mostlydiyrf/UDVBM-1/README.md

# UDVBM-1
Kicad (ver.6) design files, Arduino sketches, and user documents.
