mostlydiyrf/UDVBM-1/docs/UDVBM-1_schematics.pdf

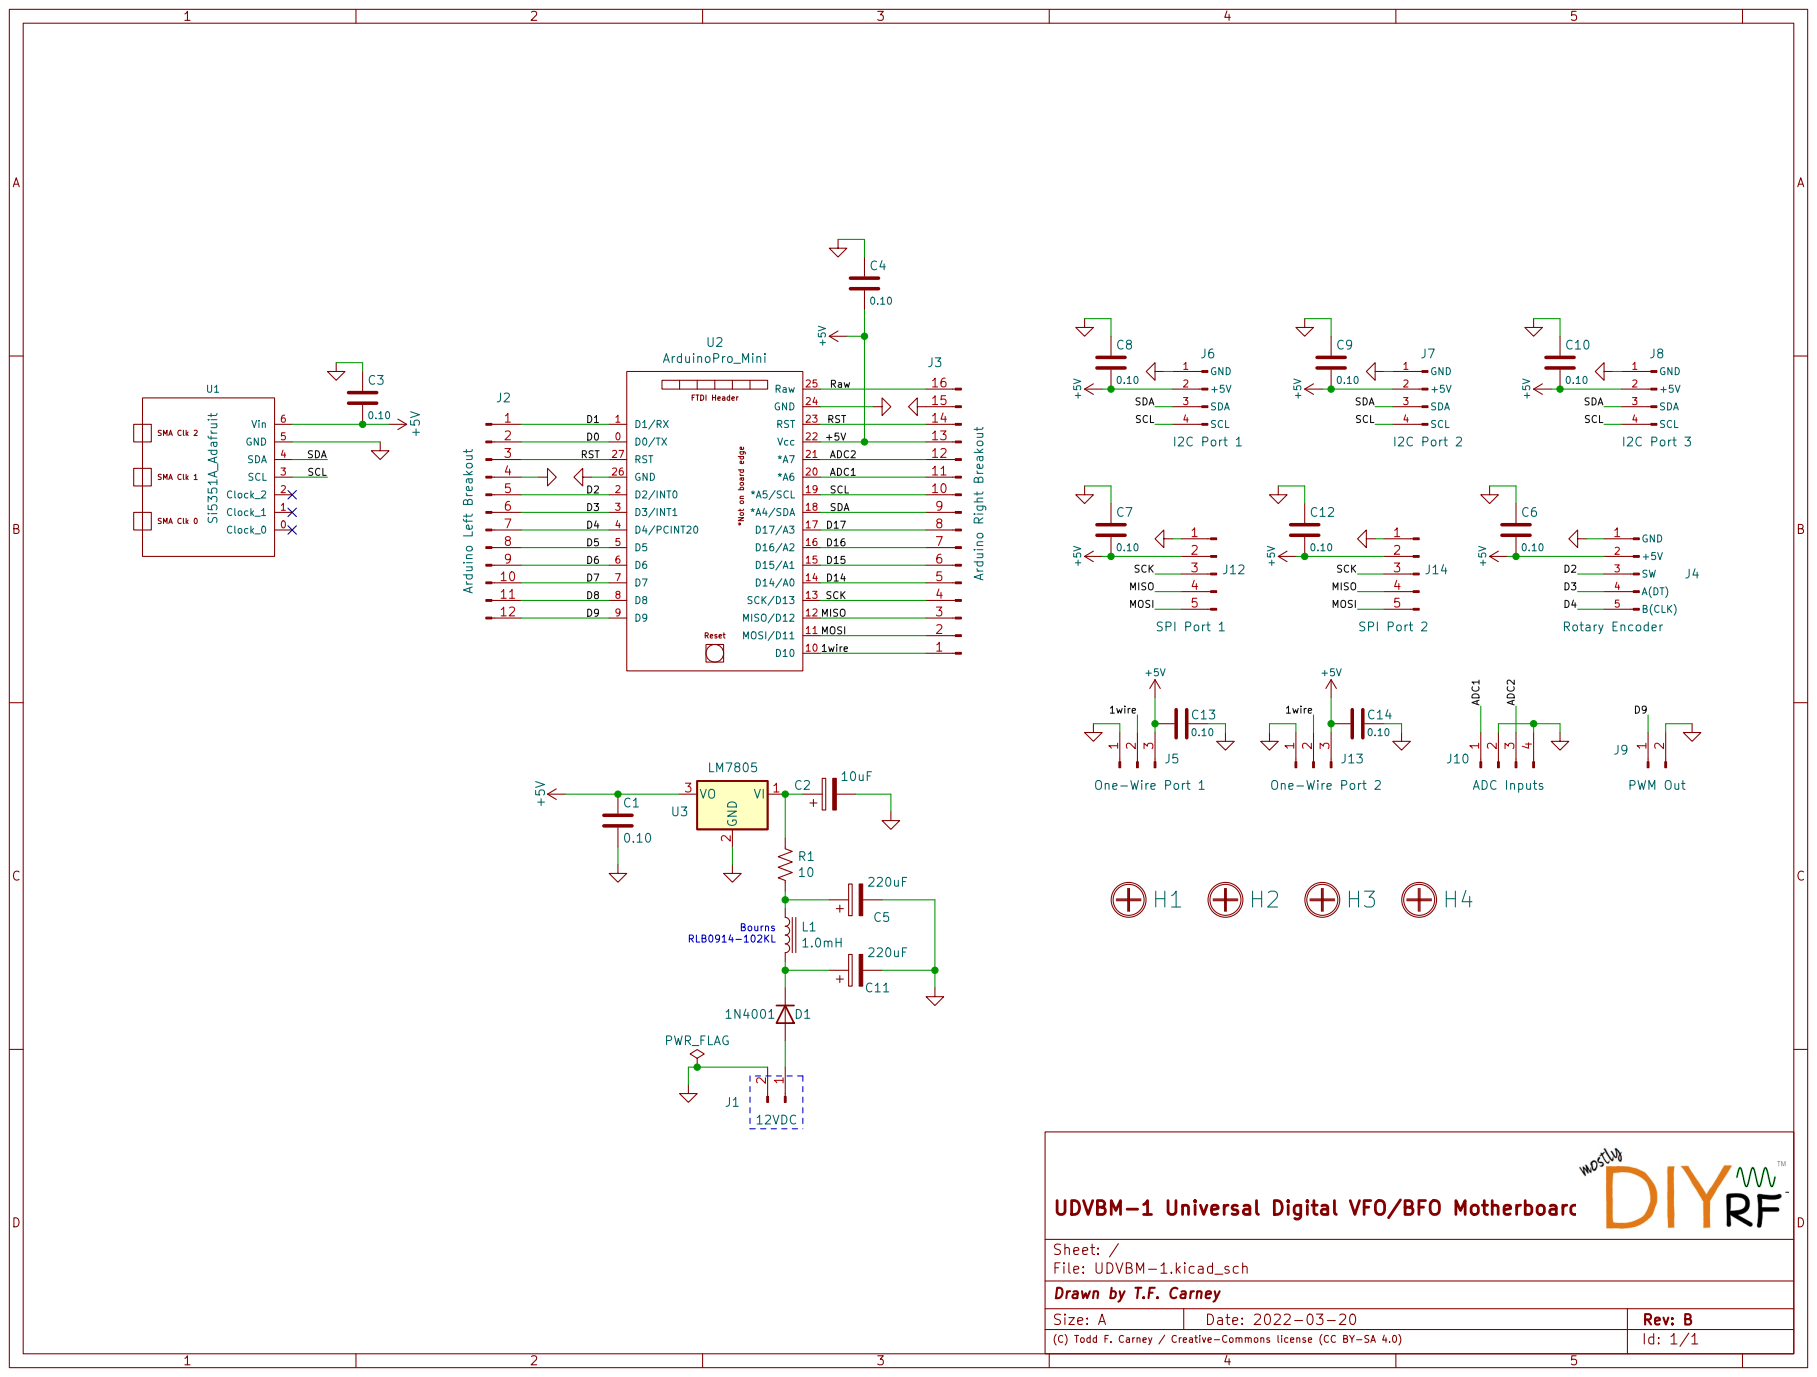
[picture p24: page 1]

File: UDVBM-1.kicad_sch Sheet: / UDVBM-1 Universal Digital VFO/BFO Motherboard

Id: 1/1 Drawn by T.F. Carney

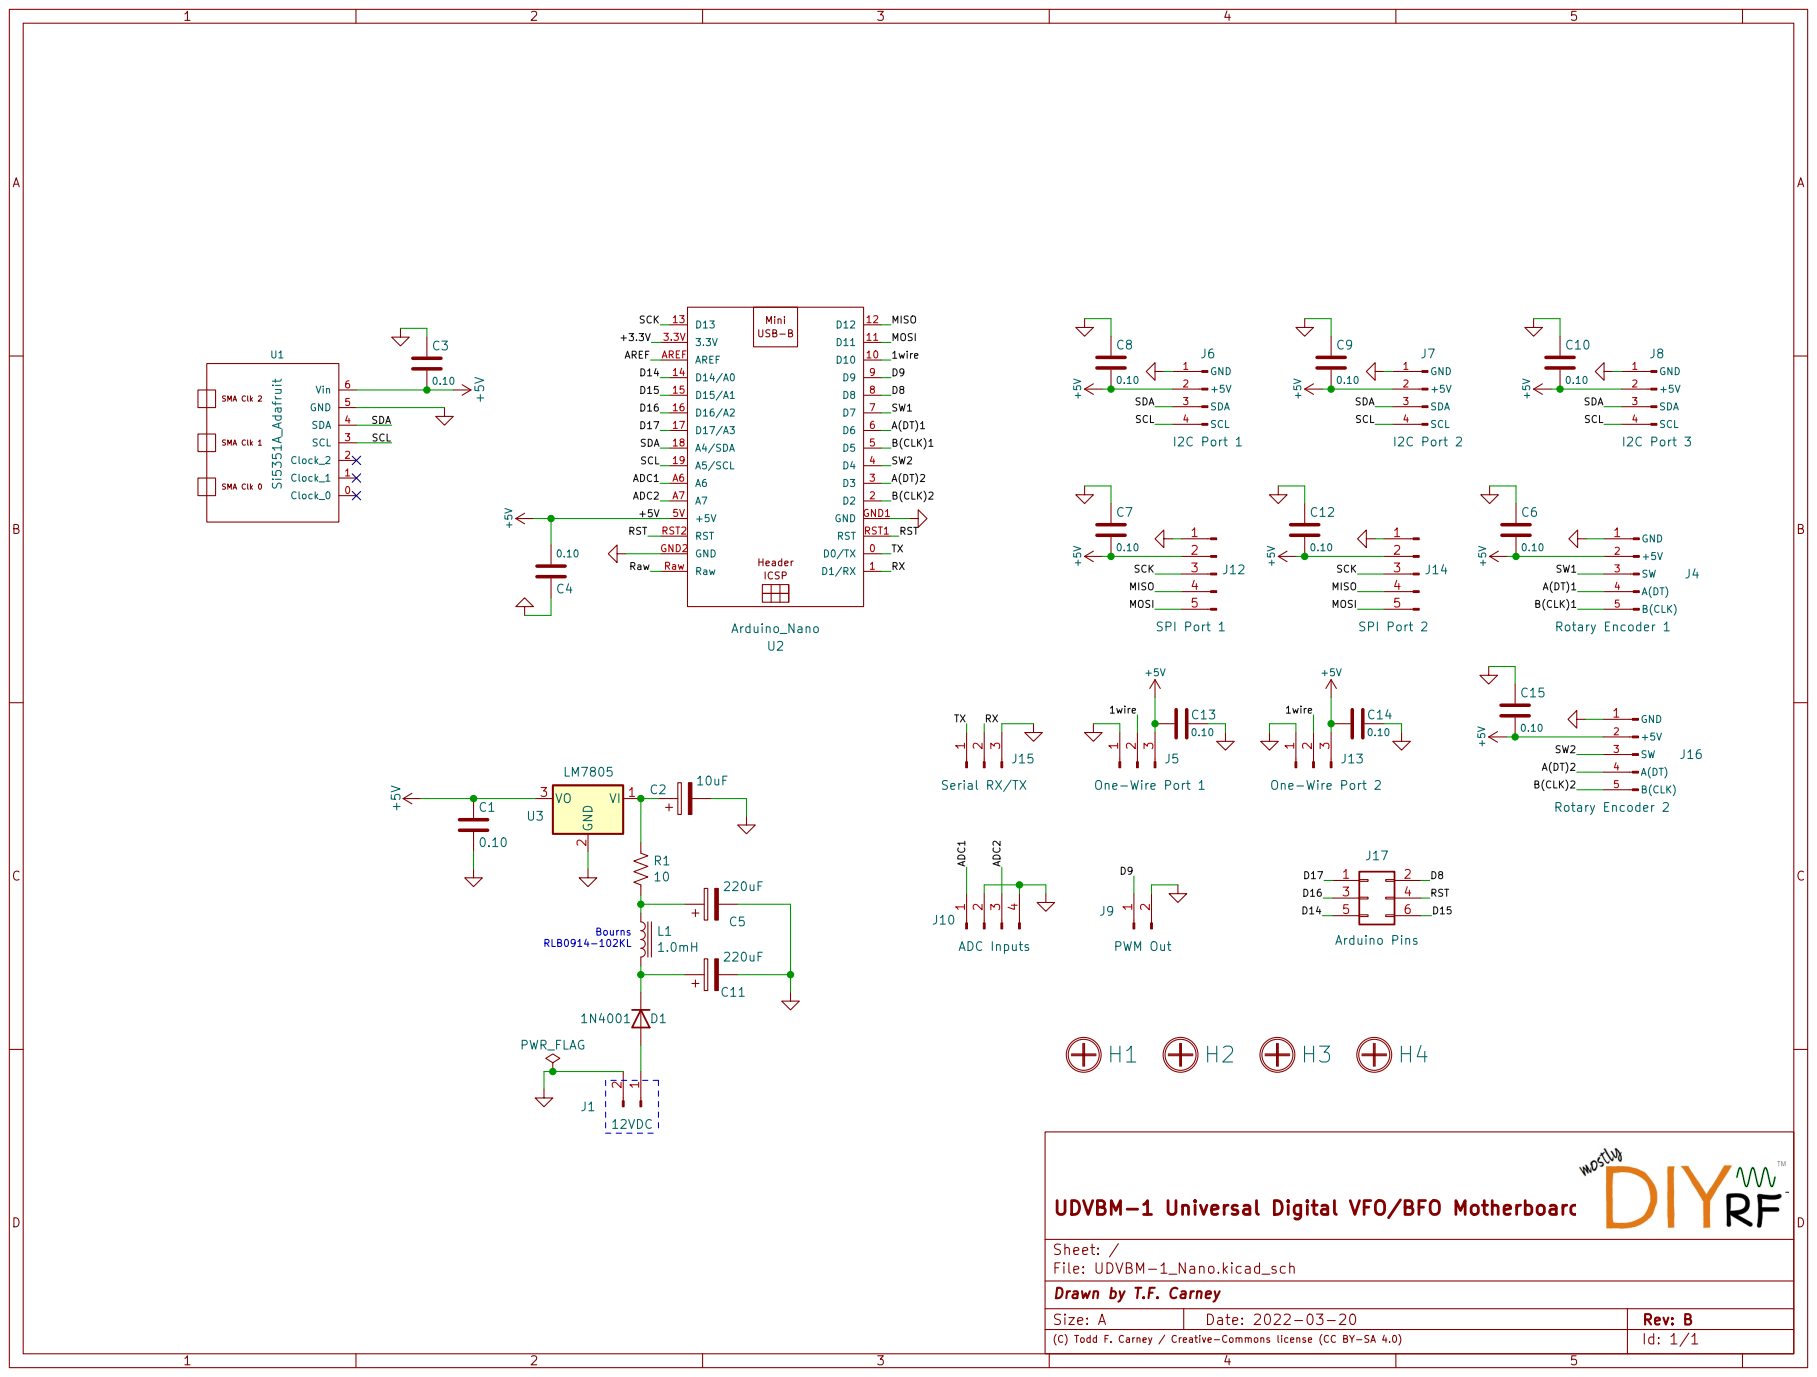
[picture p25: page 2]

File: UDVBM-1_Nano.kicad_sch Sheet: / UDVBM-1 Universal Digital VFO/BFO Motherboard

Id: 1/1 Drawn by T.F. Carney

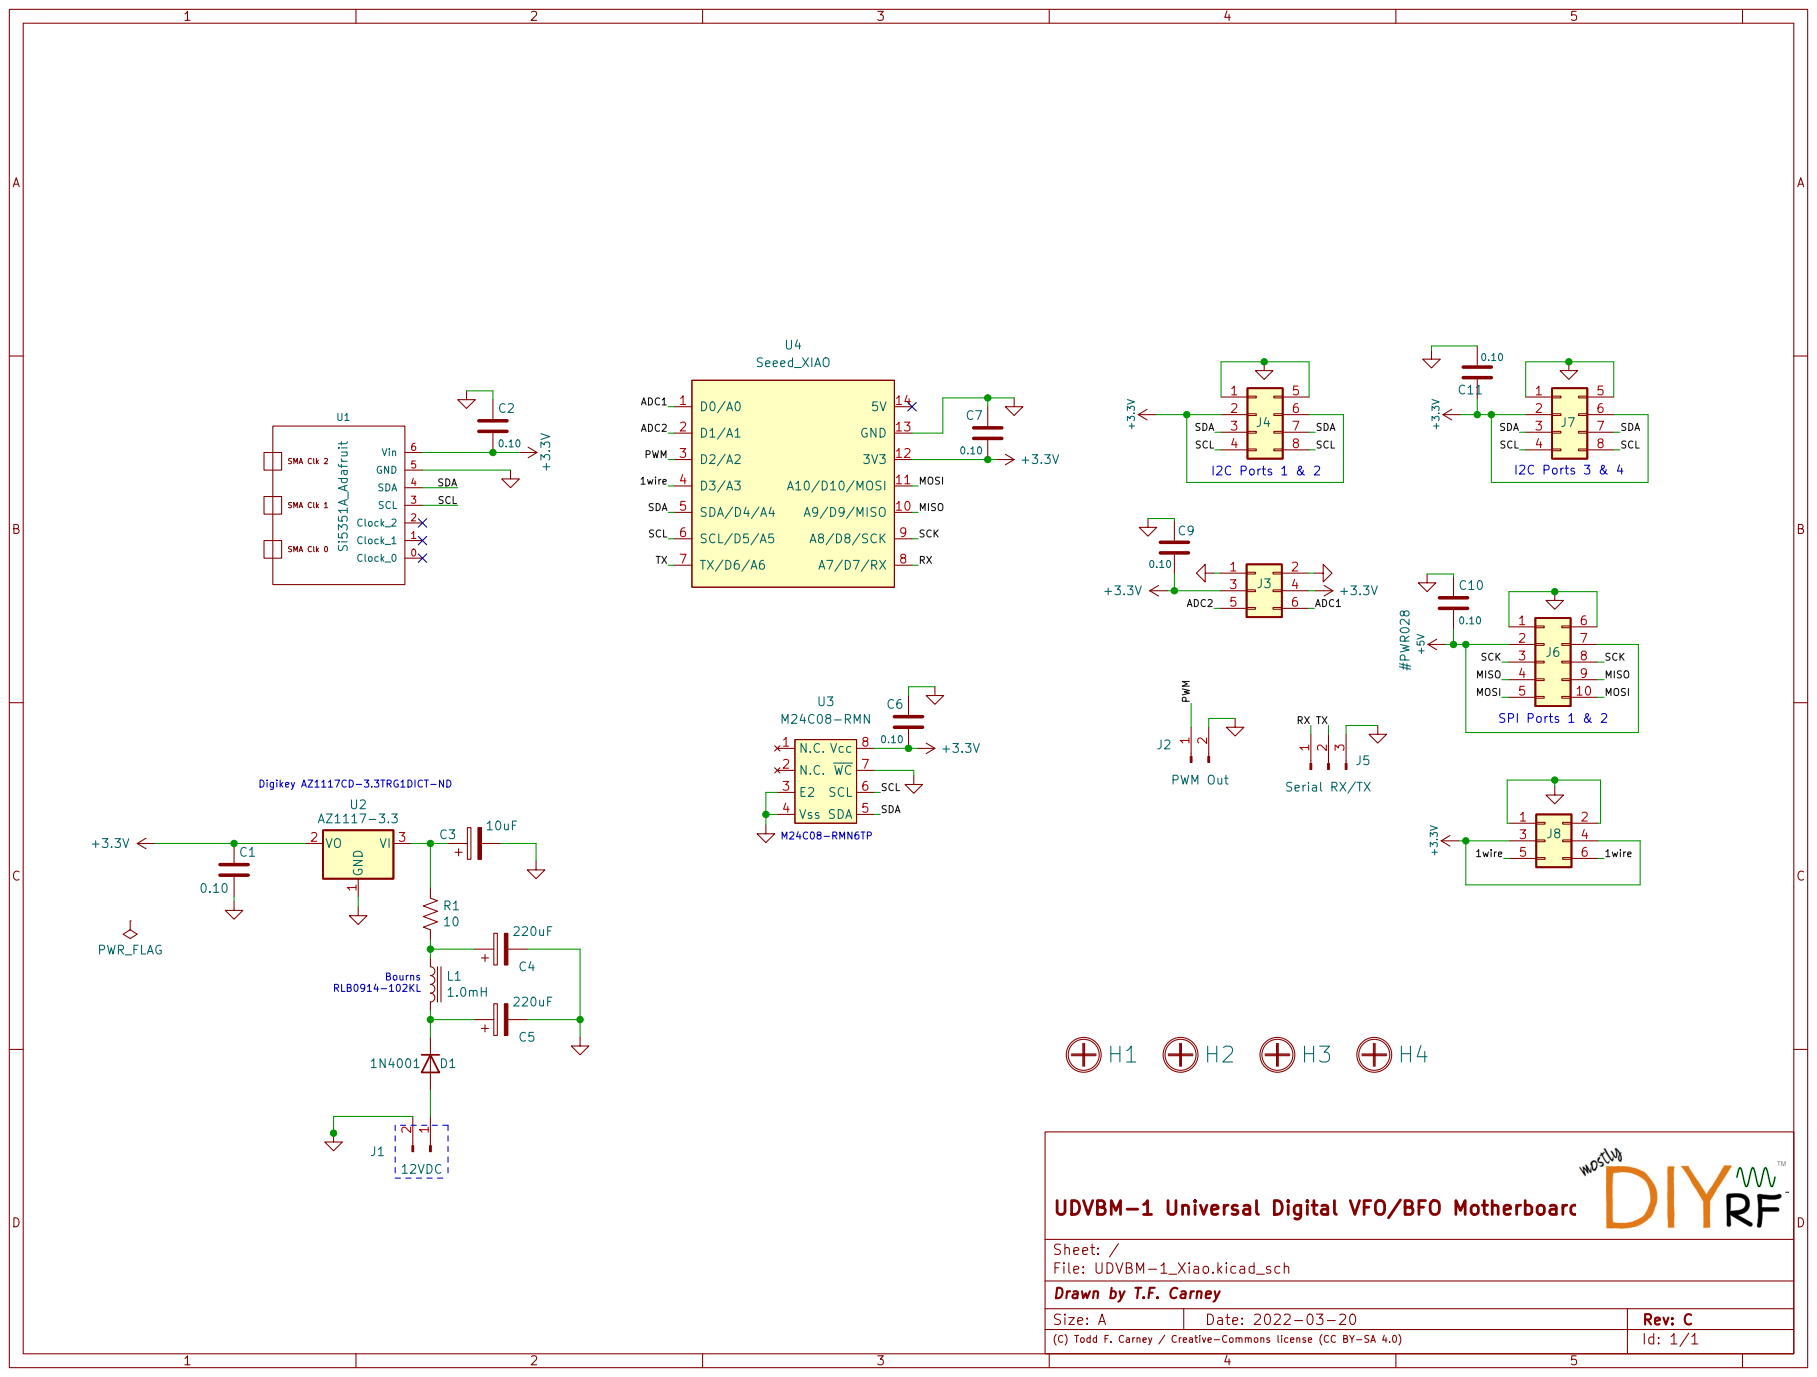
[picture p26: page 3]

File: UDVBM-1_Xiao.kicad_sch Sheet: / UDVBM-1 Universal Digital VFO/BFO Motherboard

Id: 1/1 Drawn by T.F. Carney
