mostlydiyrf/UDVBM-1/kicad6/pro-mini/UDVBM-1.kicad_pcb

## KiCad design kicad6/pro-mini/UDVBM-1.kicad_pcb (2022-08-17)

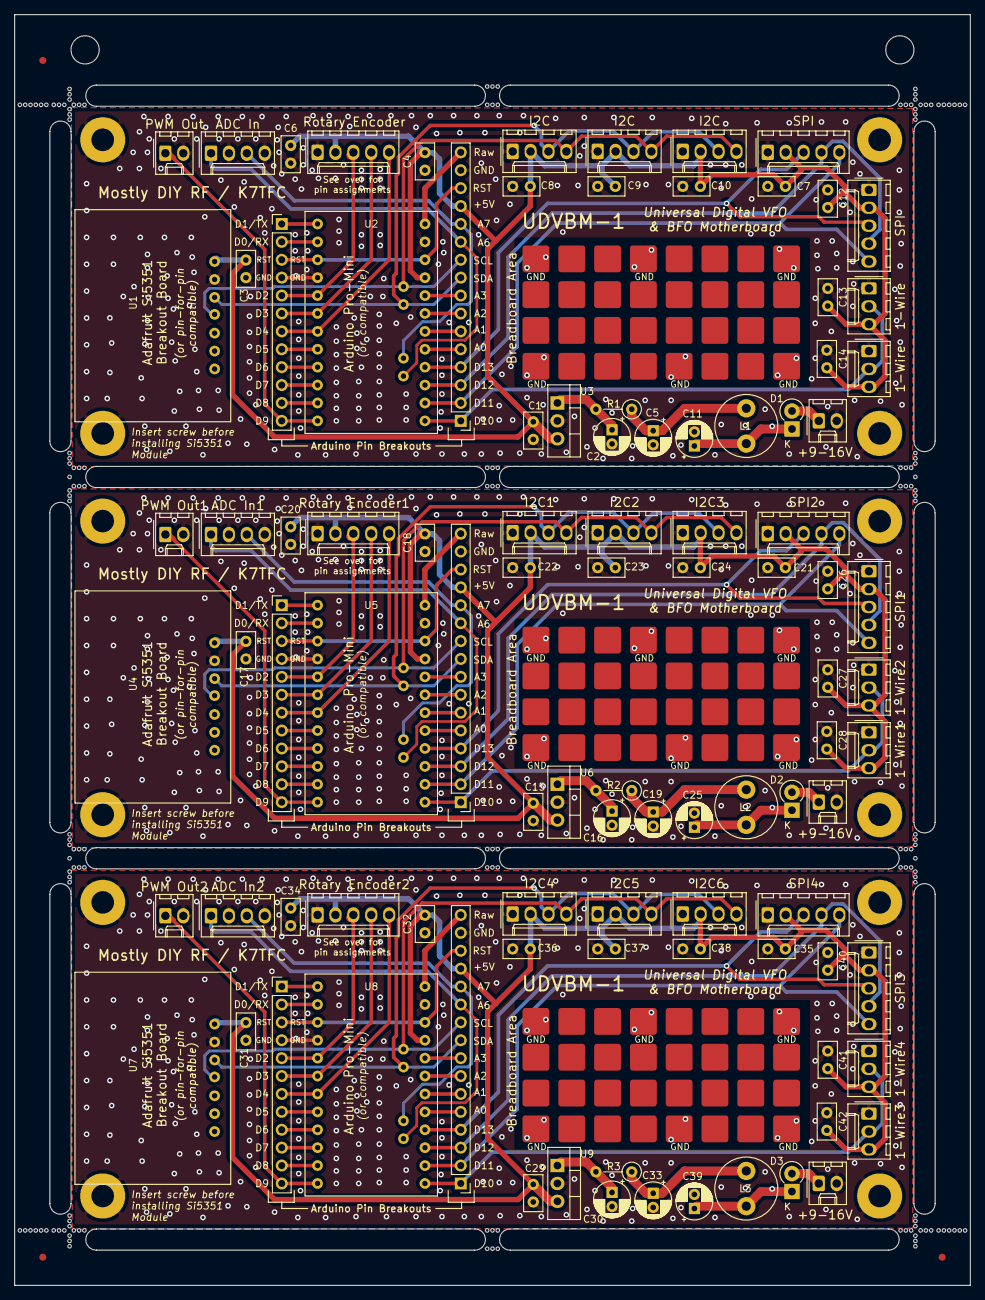
[picture p27: board UDVBM-1.kicad_pcb from above]

Board: 2 copper layers, 135.6 x 180.3 mm, 111 parts (0 on the bottom side), 33 nets.

Parts:
1-Wire, 1-Wire2, 1-Wire4: One-Wire Port 1; Molex_KK-254_AE-6410-03A_1x03_P2.54mm_Vertical
1-Wire1, 1-Wire3, 1-Wire#2: One-Wire Port 2; Molex_KK-254_AE-6410-03A_1x03_P2.54mm_Vertical
ADC In, ADC In1, ADC In2: ADC Inputs; Molex_KK-254_AE-6410-04A_1x04_P2.54mm_Vertical
C1, C3, C4, C6, C7, C8, C9, C10, C12, C13, C14, C15, C17, C18, C20, C21, C22, C23, C24, C26, C27, C28, C29, C31, C32, C34, C35, C36, C37, C38, C40, C41, C42: 0.10; C_Disc_D5.0mm_W2.5mm_P2.50mm
C2, C16, C30: 10uF; CP_Radial_D5.0mm_P2.00mm
C5, C11, C19, C25, C33, C39: 220uF; CP_Radial_D5.0mm_P2.00mm
D1, D2, D3: 1N4001; D_DO-41_SOD81_P2.54mm_Vertical_KathodeUp
H1, H2, H3, H4, H5, H6, H7, H8, H9, H10, H11, H12: Mounting_Hole_4-40; MountingHole_3.2mm_M3_Pad
I2C, I2C1, I2C4: I2C Port 1; Molex_KK-254_AE-6410-04A_1x04_P2.54mm_Vertical
I2C2, I2C5, I2C#3: I2C Port 2; Molex_KK-254_AE-6410-04A_1x04_P2.54mm_Vertical
I2C3, I2C6, I2C#2: I2C Port 3; Molex_KK-254_AE-6410-04A_1x04_P2.54mm_Vertical
J1, J4, J7: 12VDC; Molex_KK-254_AE-6410-02A_1x02_P2.54mm_Vertical
J2, J5, J8: Arduino Left Breakout; PinHeader_1x12_P2.54mm_Vertical
J3, J6, J9: Arduino Right Breakout; PinHeader_1x16_P2.54mm_Vertical
L1, L2, L3: 1.0mH; L_Radial_D8.7mm_P5.00mm_Fastron_07HCP
PWM Out, PWM Out1, PWM Out2: PWM Out; Molex_KK-254_AE-6410-02A_1x02_P2.54mm_Vertical
R1, R2, R3: 10; R_Axial_DIN0207_L6.3mm_D2.5mm_P5.08mm_Vertical
Rotary Encoder, Rotary Encoder1, Rotary Encoder2: Rotary Encoder; Molex_KK-254_AE-6410-05A_1x05_P2.54mm_Vertical
SPI, SPI2, SPI4: SPI Port 1; Molex_KK-254_AE-6410-05A_1x05_P2.54mm_Vertical
SPI1, SPI3: SPI Port 2; Molex_KK-254_AE-6410-05A_1x05_P2.54mm_Vertical
SPI#2: SPI Port 2; Molex_KK-254_AE-6410-05A_1x05_P2.54mm_Vertical
U1, U4, U7: Si5351A_Adafruit
U2, U5, U8: ArduinoPro_Mini; Arduino_Pro_Mini
U3, U6, U9: LM7805; TO-220-3_Vertical

Connections:
+5V: 1-Wire.3, 1-Wire1.3, 1-Wire2.3, 1-Wire3.3, 1-Wire4.3, 1-Wire#2.3, C1.1, C3.2, C4.2, C6.2, C7.2, C8.2, C9.2, C10.2, C12.2, C13.2, C14.2, C15.1, C17.2, C18.2, C20.2, C21.2, C22.2, C23.2, C24.2, C26.2, C27.2, C28.2, C29.1, C31.2, C32.2, C34.2, C35.2, C36.2, C37.2, C38.2, C40.2, C41.2, C42.2, I2C.2, I2C1.2, I2C2.2, I2C3.2, I2C4.2, I2C5.2, I2C6.2, I2C#2.2, I2C#3.2, J3.13, J6.13, J9.13, Rotary Encoder.2, Rotary Encoder1.2, Rotary Encoder2.2, SPI.2, SPI1.2, SPI2.2, SPI3.2, SPI4.2, SPI#2.2, U1.6, U2.22, U3.3, U4.6, U5.22, U6.3, U7.6, U8.22, U9.3
/1wire: 1-Wire.2, 1-Wire1.2, 1-Wire2.2, 1-Wire3.2, 1-Wire4.2, 1-Wire#2.2, J3.1, J6.1, J9.1, U2.10, U5.10, U8.10
/ADC1: ADC In.1, ADC In1.1, ADC In2.1, J3.11, J6.11, J9.11, U2.20, U5.20, U8.20
/ADC2: ADC In.3, ADC In1.3, ADC In2.3, J3.12, J6.12, J9.12, U2.21, U5.21, U8.21
/D0: J2.2, J5.2, J8.2, U2.0, U5.0, U8.0
/D1: J2.1, J5.1, J8.1, U2.1, U5.1, U8.1
/D2: J2.5, J5.5, J8.5, Rotary Encoder.3, Rotary Encoder1.3, Rotary Encoder2.3, U2.2, U5.2, U8.2
/D3: J2.6, J5.6, J8.6, Rotary Encoder.4, Rotary Encoder1.4, Rotary Encoder2.4, U2.3, U5.3, U8.3
/D4: J2.7, J5.7, J8.7, Rotary Encoder.5, Rotary Encoder1.5, Rotary Encoder2.5, U2.4, U5.4, U8.4
/D5: J2.8, J5.8, J8.8, U2.5, U5.5, U8.5
/D6: J2.9, J5.9, J8.9, U2.6, U5.6, U8.6
/D7: J2.10, J5.10, J8.10, U2.7, U5.7, U8.7
/D8: J2.11, J5.11, J8.11, U2.8, U5.8, U8.8
/D9: J2.12, J5.12, J8.12, PWM Out.1, PWM Out1.1, PWM Out2.1, U2.9, U5.9, U8.9
/D14: J3.5, J6.5, J9.5, U2.14, U5.14, U8.14
/D15: J3.6, J6.6, J9.6, U2.15, U5.15, U8.15
/D16: J3.7, J6.7, J9.7, U2.16, U5.16, U8.16
/D17: J3.8, J6.8, J9.8, U2.17, U5.17, U8.17
/MISO: J3.3, J6.3, J9.3, SPI.4, SPI1.4, SPI2.4, SPI3.4, SPI4.4, SPI#2.4, U2.12, U5.12, U8.12
/MOSI: J3.2, J6.2, J9.2, SPI.5, SPI1.5, SPI2.5, SPI3.5, SPI4.5, SPI#2.5, U2.11, U5.11, U8.11
/RST: J2.3, J3.14, J5.3, J6.14, J8.3, J9.14, U2.23, U2.27, U5.23, U5.27, U8.23, U8.27
/Raw: J3.16, J6.16, J9.16, U2.25, U5.25, U8.25
/SCK: J3.4, J6.4, J9.4, SPI.3, SPI1.3, SPI2.3, SPI3.3, SPI4.3, SPI#2.3, U2.13, U5.13, U8.13
/SCL: I2C.4, I2C1.4, I2C2.4, I2C3.4, I2C4.4, I2C5.4, I2C6.4, I2C#2.4, I2C#3.4, J3.10, J6.10, J9.10, U1.3, U2.19, U4.3, U5.19, U7.3, U8.19
/SDA: I2C.3, I2C1.3, I2C2.3, I2C3.3, I2C4.3, I2C5.3, I2C6.3, I2C#2.3, I2C#3.3, J3.9, J6.9, J9.9, U1.4, U2.18, U4.4, U5.18, U7.4, U8.18
GND: 1-Wire.1, 1-Wire1.1, 1-Wire2.1, 1-Wire3.1, 1-Wire4.1, 1-Wire#2.1, ADC In.2, ADC In.4, ADC In1.2, ADC In1.4, ADC In2.2, ADC In2.4, C1.2, C2.2, C3.1, C4.1, C5.2, C6.1, C7.1, C8.1, C9.1, C10.1, C11.2, C12.1, C13.1, C14.1, C15.2, C16.2, C17.1, C18.1, C19.2, C20.1, C21.1, C22.1, C23.1, C24.1, C25.2, C26.1, C27.1, C28.1, C29.2, C30.2, C31.1, C32.1, C33.2, C34.1, C35.1, C36.1, C37.1, C38.1, C39.2, C40.1, C41.1, C42.1, I2C.1, I2C1.1, I2C2.1, I2C3.1, I2C4.1, I2C5.1, I2C6.1, I2C#2.1, I2C#3.1, J1.2, J2.4, J3.15, J4.2, J5.4, J6.15, J7.2, J8.4, J9.15, PWM Out.2, PWM Out1.2, PWM Out2.2, Rotary Encoder.1, Rotary Encoder1.1, Rotary Encoder2.1, SPI.1, SPI1.1, SPI2.1, SPI3.1, SPI4.1, SPI#2.1, U1.5, U2.24, U2.26, U3.2, U4.5, U5.24, U5.26, U6.2, U7.5, U8.24, U8.26, U9.2
unnamed: C2.1, C16.1, C30.1, R1.2, R2.2, R3.2, U3.1, U6.1, U9.1
unnamed: C5.1, C19.1, C33.1, L1.1, L2.1, L3.1, R1.1, R2.1, R3.1
unnamed: C11.1, C25.1, C39.1, D1.1, D2.1, D3.1, L1.2, L2.2, L3.2
unnamed: D1.2, D2.2, D3.2, J1.1, J4.1, J7.1
unnamed: U1.0, U4.0, U7.0
unnamed: U1.1, U4.1, U7.1
unnamed: U1.2, U4.2, U7.2
