mostlydiyrf/UDVBM-1/kicad6/xiao/UDVBM-1_Nano.kicad_pcb

## KiCad design kicad6/xiao/UDVBM-1_Nano.kicad_pcb (2022-08-17)

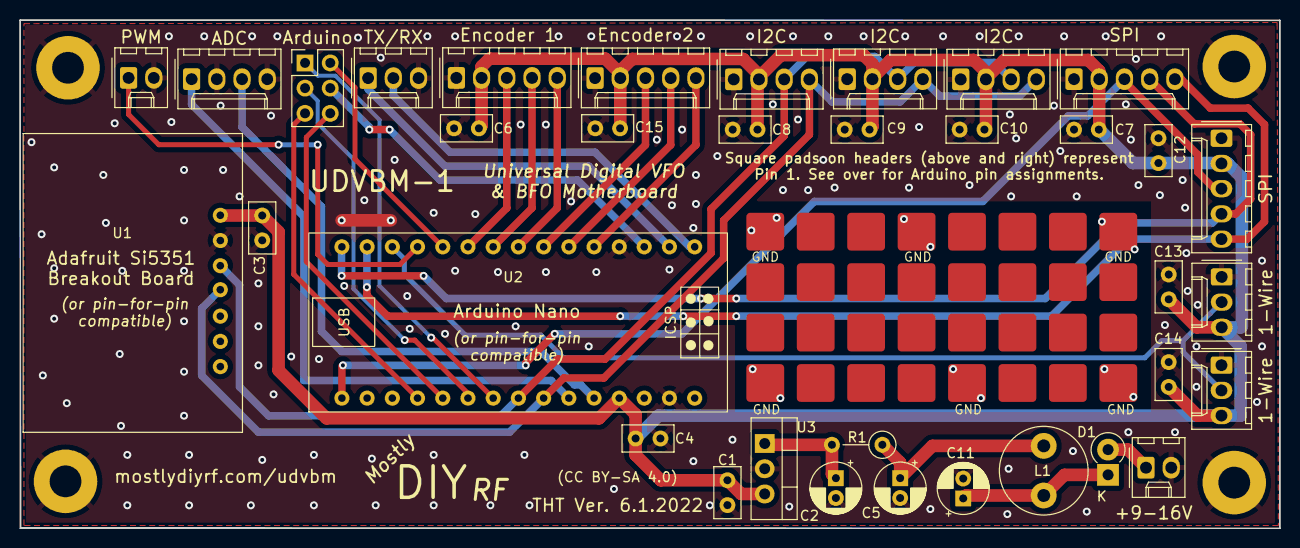
[picture p28: board UDVBM-1_Nano.kicad_pcb from above]

Board: 2 copper layers, 126.9 x 51.2 mm, 39 parts (0 on the bottom side), 29 nets.

Parts:
1-Wire: One-Wire Port 1; Molex_KK-254_AE-6410-03A_1x03_P2.54mm_Vertical
1-Wire#2: One-Wire Port 2; Molex_KK-254_AE-6410-03A_1x03_P2.54mm_Vertical
ADC: ADC Inputs; Molex_KK-254_AE-6410-04A_1x04_P2.54mm_Vertical
Arduino: Arduino Pins; PinHeader_2x03_P2.54mm_Vertical
C1, C3, C4, C6, C7, C8, C9, C10, C12, C13, C14, C15: 0.10; C_Disc_D5.0mm_W2.5mm_P2.50mm
C2: 10uF; CP_Radial_D5.0mm_P2.00mm
C5, C11: 220uF; CP_Radial_D5.0mm_P2.00mm
D1: 1N4001; D_DO-41_SOD81_P2.54mm_Vertical_KathodeUp
Encoder 1: Rotary Encoder 1; Molex_KK-254_AE-6410-05A_1x05_P2.54mm_Vertical
Encoder 2: Rotary Encoder 2; Molex_KK-254_AE-6410-05A_1x05_P2.54mm_Vertical
H1, H2, H3, H4: Mounting_Hole_4-40; MountingHole_3.2mm_M3_Pad
I2C: I2C Port 1; Molex_KK-254_AE-6410-04A_1x04_P2.54mm_Vertical
I2C#2: I2C Port 3; Molex_KK-254_AE-6410-04A_1x04_P2.54mm_Vertical
I2C#3: I2C Port 2; Molex_KK-254_AE-6410-04A_1x04_P2.54mm_Vertical
J1: 12VDC; Molex_KK-254_AE-6410-02A_1x02_P2.54mm_Vertical
L1: 1.0mH; L_Radial_D8.7mm_P5.00mm_Fastron_07HCP
PWM: PWM Out; Molex_KK-254_AE-6410-02A_1x02_P2.54mm_Vertical
R1: 10; R_Axial_DIN0207_L6.3mm_D2.5mm_P5.08mm_Vertical
SPI: SPI Port 1; Molex_KK-254_AE-6410-05A_1x05_P2.54mm_Vertical
SPI#2: SPI Port 2; Molex_KK-254_AE-6410-05A_1x05_P2.54mm_Vertical
TX/RX: Serial RX/TX; Molex_KK-254_AE-6410-03A_1x03_P2.54mm_Vertical
U1: Si5351A_Adafruit
U2: Arduino_Nano
U3: LM7805; TO-220-3_Vertical

Connections:
+5V: 1-Wire.3, 1-Wire#2.3, C1.1, C3.2, C4.2, C6.2, C7.2, C8.2, C9.2, C10.2, C12.2, C13.2, C14.2, C15.2, Encoder 1.2 (+5V), Encoder 2.2 (+5V), I2C.2 (+5V), I2C#2.2 (+5V), I2C#3.2 (+5V), SPI.2, SPI#2.2, U1.6 (Vin), U2.5V (+5V), U3.3 (VO)
/1wire: 1-Wire.2, 1-Wire#2.2, U2.10 (D10)
/A(DT)1: Encoder 1.4 (A(DT)), U2.6 (D6)
/A(DT)2: Encoder 2.4 (A(DT)), U2.3 (D3)
/ADC1: ADC.1, U2.A6
/ADC2: ADC.3, U2.A7
/B(CLK)1: Encoder 1.5 (B(CLK)), U2.5 (D5)
/B(CLK)2: Encoder 2.5 (B(CLK)), U2.2 (D2)
/D8: Arduino.2, U2.8 (D8)
/D9: PWM.1, U2.9 (D9)
/D14: Arduino.5, U2.14 (D14/A0)
/D15: Arduino.6, U2.15 (D15/A1)
/D16: Arduino.3, U2.16 (D16/A2)
/D17: Arduino.1, U2.17 (D17/A3)
/MISO: SPI.4, SPI#2.4, U2.12 (D12)
/MOSI: SPI.5, SPI#2.5, U2.11 (D11)
/RST: Arduino.4, U2.RST1 (RST), U2.RST2 (RST)
/RX: TX/RX.2, U2.1 (D1/RX)
/SCK: SPI.3, SPI#2.3, U2.13 (D13)
/SCL: I2C.4 (SCL), I2C#2.4 (SCL), I2C#3.4 (SCL), U1.3 (SCL), U2.19 (A5/SCL)
/SDA: I2C.3 (SDA), I2C#2.3 (SDA), I2C#3.3 (SDA), U1.4 (SDA), U2.18 (A4/SDA)
/SW1: Encoder 1.3 (SW), U2.7 (D7)
/SW2: Encoder 2.3 (SW), U2.4 (D4)
/TX: TX/RX.1, U2.0 (D0/TX)
GND: 1-Wire.1, 1-Wire#2.1, ADC.2, ADC.4, C1.2, C2.2, C3.1, C4.1, C5.2, C6.1, C7.1, C8.1, C9.1, C10.1, C11.2, C12.1, C13.1, C14.1, C15.1, Encoder 1.1 (GND), Encoder 2.1 (GND), I2C.1 (GND), I2C#2.1 (GND), I2C#3.1 (GND), J1.2, PWM.2, SPI.1, SPI#2.1, TX/RX.3, U1.5 (GND), U2.GND1 (GND), U2.GND2 (GND), U3.2 (GND)
unnamed: C2.1, R1.2, U3.1 (VI)
unnamed: C5.1, L1.1, R1.1
unnamed: C11.1, D1.1 (K), L1.2
unnamed: D1.2 (A), J1.1
