mostlydiyrf/UDVBM-1/(notices)

Notices in the files:
kicad6/xiao/UDVBM-1_Nano.kicad_pcb:
(CC BY-SA 4.0)
